lnls-dig/rffe-hw/circuit_board/controller/manufacturing/RFFE_Controller_PCB_specs.docx

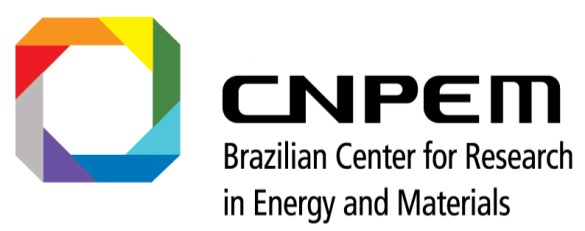
[picture p1: figure]
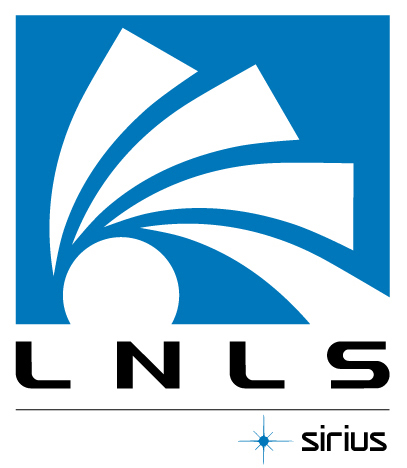
[picture p2: figure]

RFFE_Controller_v7

Manufacturing specifications

November 2015

Beam Diagnostics Group (DIG)

BLANK PAGE

# PCB Fabrication Specification

Design references
Name | RFFE_Controller_v6 | | Date: 25/11/2014
File name
Designer | Rafael Antonio Baron | Fernando Sant’anna
E-mail | | fernando.santanna@lnls.br
Fone | | +55 19 3512-5071
Cel | | +55 19 99206-8595

Mechanical characteristics
External size (mm) | 87 mm x 105 mm
Thickness (mm) | 1.6 mm
Multilayers | 4 layers
Min track width (mm/mils) | 0.1mm
Min Hole size (mm/mils) | 0.254mm
Laminate | FR-4 – TG150
Pre-preg | FR-4 – TG150

Finish Copper
External layers (µm) | 35 µm
Holes walls (µm) | 25 µm
Internal Layers-Planes (µm) | 35 µm
Internal Layers-Signals (µm) | 35 µm

Board finishing requirements
Mask Solder color | Red for prototype and Blue for production
Silkscreen on top layer (color) | White
Silkscreen on bottom layer (color) | White
Surface Finishing | ENIG – Electroless Nickel / Immersion Gold according to IPC-4552
Thickness | Ni: 3 µm min, 6 µm máx. Au: 0.05 µm min, 0.125 µm máx

Additional Information
Impedance test | No
Packaging requirements | No
Documentation to be delivered | No
Additional control quality requirements | No

Board Stackup Information
Layer 1 | RF signals | Laminate/pre-preg | Thickness (mm/mils)
Layer 2 | RF Ground Plane | FR4 | 20 mils
Layer 3 | Digital signaling | FR4 | 20 mils
Layer 4 | Digital Ground plane | FR4 | 20 mils

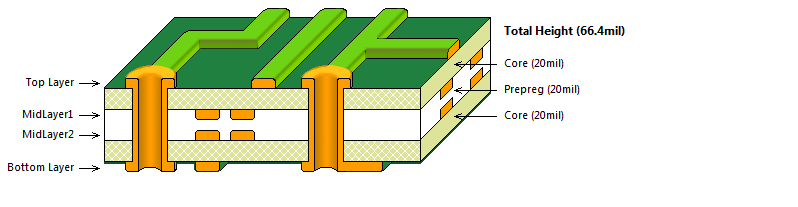
[picture p3: figure]

60 mils (1.6 mm)

Centro Nacional de Pesquisa em Energia e Materiais (CNPEM) Laboratório Nacional de Luz Síncrotron (LNLS) Rua Giuseppe Maximo Scolfaro, 10000, Polo II de Alta Tecnologia Campinas, São Paulo, Brazil CEP 13083-970 – Caixa Postal 6192

Last update: 23 May 2016 - 15:59 4
