lnls-dig/rffe-hw/circuit_board/rf_channels/manufacturing/RFFE_PCB_specs.docx

RFFE_v2_AC

RFFE_v2_BD

Manufacturing specifications

November 2015

Beam Diagnostics Group (DIG)

BLANK PAGE

# PCB Fabrication Specification

Design references
Name | RFFE_V2_AC and RFFE_V2_BD | | Date: 25/11/2014
File name
Designer | Rafael Antonio Baron | Fernando Sant’anna
E-mail | | fernando.santanna@lnls.br
Fone | | +55 19 3512-5071
Cel | | +55 16 99206-8595

Mechanical characteristics
External size (mm) | 50 mm x 105 mm
Thickness (mm) | 1.6 mm
Number of layers | 4 layers
Min track width (mm/mils) | 0.203mm / 8 mils
Min Hole size (mm/mils) | 0.200mmm / 7.8 mils
Laminate | RO4350 on top layer
Pre-preg | FR-4

Finish Copper Thickness
External layers (µm) | 35 µm
Via plating (µm) | 25 µm
Internal Layers-Planes (µm) | 35 µm
Internal Layers-Signals (µm) | 35 µm

Board finishing requirements
Silkscreen on top layer (color) | White
Silkscreen on bottom layer (color) | White
Board color | Red
Surface Finishing | ENIG – Electroless Nickel / Immersion Gold according to IPC-4552
Thickness | Ni: 3 µm min, 6 µm máx. Au: 0.05 µm min, 0.125 µm máx

Additional Information
Impedance test | No
Packaging requirements | No
Documentation to be delivered | No
Additional control quality requirements | No

Board Stackup Information
Layer 1 | RF signals | Laminate/pre-preg | Thickness (mm/mils)
Layer 2 | RF Ground Plane | RO4350 | 20 mils
Layer 3 | Digital signaling | FR4 | 20 mils
Layer 4 | Digital Ground plane | FR4 | 20 mils

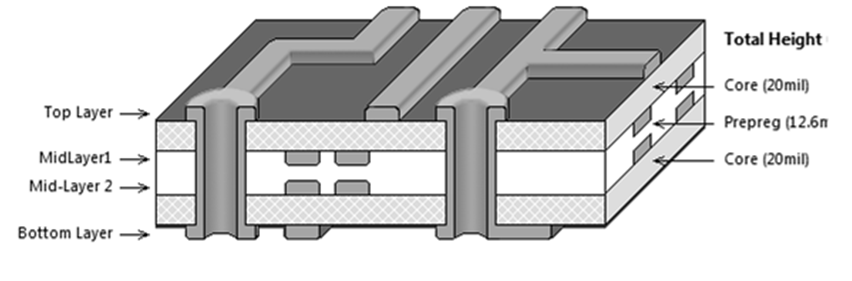
[picture p4: figure]

(20 mil) Rogers RO4350

(20 mil) FR-4

(20 mil) FR-4

60 mils (1.6 mm)

Centro Nacional de Pesquisa em Energia e Materiais (CNPEM) Laboratório Nacional de Luz Síncrotron (LNLS) Rua Giuseppe Maximo Scolfaro, 10000, Polo II de Alta Tecnologia Campinas, São Paulo, Brazil CEP 13083-970 – Caixa Postal 6192

Last update: 5 January 2016 - 11:08 4
