lnls-dig/rffe-hw/mechanical/RFFE_SET_BOM/BOM for 1U 19Pol two box RFFE.xlsx

BILL OF MATERIALS
Project: | 1U - 19" Two box RFFE | REV.: 1 | Data: | 29/10/2015
Quantity | Description | Manufacturer PN | Manufacturer | Link
2 | Light pipe for front panel | 51513010125F | Dialight | http://www.digikey.com/product-detail/en/51513010125F/350-3721-ND/4965176 | 0.86 | 3.44
1 | Panel 1U 19" for two RFFE units and Screws | PAINEL_RFFEv1BI | HDL USINAGEM | send to: fernando.santanna@lnls.br to take a mechanical drawings
2 | Cable Flex RED - 24AWG - 10cm | AP107177 | Mult Cabo | send to: fernando.santanna@lnls.br to take a mechanical drawings | 1 | 4
2 | Cable Flex Black - 24AWG - 10cm | AP107176 | Mult Cabo | send to: fernando.santanna@lnls.br to take a mechanical drawings | 1 | 4
2 | Rocker switch | RB141C1000-114 | E-Switch | http://www.digikey.com/product-detail/en/RB141C1000-114/RB141C1000-114-ND/3778078 | 1.09 | 4.36
2 | Mechanical enclosure RFFE box + 2x shield 2mm | BOX_RFFEv5BI | HDL USINAGEM | send to: fernando.santanna@lnls.br to take a mechanical drawings
2 | Fuse holder(slot) | BK/HTB-52M-R | Eaton Bussmann | http://www.digikey.com/product-detail/en/BK%2FHTB-52M-R/283-3839-ND/1024133 | 7 | 28
2 | Fuse 2A 5x20 | 0217002.HXP | Littelfuse Inc. | http://www.digikey.com/product-detail/en/0217002.HXP/F2393-ND/777109 | 1 | 4
2 | CONN DUST COVER - MINI USB BLACK | MUSB2E151015BP | Amphenol | https://www.amphenolcanada.com/ProductSearch/drawings/AC/MUSB2E1510X5BP.pdf | 1.5 | 6
2 | Terminal block with EMI filter | 7602-602NLF | Tusonix CTS Electronic | http://www.digikey.com/product-search/en?vendor=0&keywords=7602-602NLF | 23.04 | 92.16
2 | LASER printer Label ID whith QRCode 12x26mm | A5Q-1226 A5 | Etiqueta Pimaco | http://www.pimaco.com.br/produto/186/a5q-1226-etiquetas-a5-12-folhas | 0.01 | 0.04
 |  |  |  |  |  | 146
