lnls-dig/rffe-hw/(list of files, cad)

Other CAD files:
mechanical/RFFE_panel_1U_19_Pol/assembly_box_and_panel_1U.dwg
mechanical/RFFE_box/RFFE_box.dwg
mechanical/RFFE_panel_1U_19_Pol/RFFE_panel_1U_19pol.dwg
mechanical/RFFE_sink_2mm/heat_sink.dwg
mechanical/RFFE_box/RFFE_box.ipt
mechanical/RFFE_panel_1U_19_Pol/RFFE_panel_1U_19pol.ipt
mechanical/RFFE_panel_1U_19_Pol/assembly_box_and_panel_1U.iam
mechanical/RFFE_sink_2mm/heat_sink.ipt
