lnls-dig/rffe-hw/(list of files, drawings)

Other design files:
circuit_board/controller/RFFE_Controller.PrjPcb
circuit_board/controller/RFFE_Controller.SchDoc
circuit_board/rf_channels/RFFE.PrjPCB
circuit_board/rf_channels/RFFE.SchDoc
circuit_board/rf_channels/RFFE_AC.PcbDoc
circuit_board/rf_channels/RFFE_BD.PcbDoc
