lnls-dig/rffe-hw/(threads)

Thread 1 (2016-05-17):

Change footprints to avoid paste over via

aylons, 2016-05-17:
Paste over via may lead to improper connection and should be avoided. The footprints of TA1114A and TAMP72 have obvious instances of this problems, but a quick inspection has shown it happens several times.

Footprints and vias in all componentes should be revised to avoid this design.

Closed 2016-07-19.

Thread 2 (2016-05-18):

Via under switch pad is smaller than others

aylons, 2016-05-18:
The via under the RF switch is the only hole with 0.200 mm, requiring change of tooling for building a single hole. All others are 0.203 (8mil), which is perfectly adequate for this component footprint.

Closed 2016-07-19.

Thread 3 (2016-07-06):

Replace MBED with LPC176x controller

henrique-silva, 2016-07-06:
Using a MBED board here is a real overkill, since we only use some basic functions provided by it.
We could replace the MBED with a single LPC176x (1768 is the more suitable probably, 1769 for clocks up to 120MHz) and, with just some resistors added, we would have the same functionality.
This change would untie us from a specific product such as MBED and significantly reduce production costs.

The firmware would not need any changes if the pinout is the same as MBED, but we would lose the ability to flash the firmware via USB (drag'n'drop).
We could also use here [openMMC](https://github.com/lnls-dig/openMMC) and reimplement the current logic in separated modules, but this firmware doesn't have a fully tested Ethernet interface yet.

aylons, 2018-04-25:
This is being addresd by https://github.com/lnls-dig/rffe-uc-hw/

Closed 2018-04-25.

Thread 4 (2016-07-19):

Change heating resistors to SMD type

aylons, 2016-07-19:
The heating resistors are the last non-SMD devices in the RFFE board. Changing them to a SMD part would minimize the chance of production error by avoiding unnecessary soldering iron process.

Closed 2018-01-24.

Thread 5 (2018-04-25):

Correct pull-up/down variant for clock input

aylons, 2018-04-25:
The clock input should not have both up and down pulls, it should be chosen between two variants. The resistor value should also be changed to something closer to 50 ohms, as this is the connector impedance.

Thread 8 (2018-08-14):

Change EOL'ed parts in the schematic

aylons, 2018-08-14:
Two parts were EOL'ed and need to be replaced in the schematic:

MACOM MASWSS0184 (https://www.macom.com/products/product-detail/MASWSS0184 to replace the RFSW switch.
IDT F1953 https://www.idt.com/products/rf-products/rf-attenuators/f1953-6-bit-050db-glitch-free-digital-step-attenuator-internal-dc-blocks) to replace Mini-circuits DAT-31R5 attenuator.

Thread 9 (2022-11-10):

Change RF frequency

mo2020, 2022-11-10:
We are going to use RFFE in our machine with RF frequency of 100MHz, We are wondering if anyone highlight any changes are required in RFFE.

danielot, 2022-11-10:
Hello @mo2020. The bandpass filters (TA1113A) would definitely have to be replaced if you want to operate on the first beam harmonics, but you may want to evaluate whether 100 MHz is the best harmonics to work with. If you can get more signal from your pick ups (after cables) at higher harmonics (e.g. 300 MHz, 500 MHz) these other frequencies could be better options.

Some thoughts about switching to a different center frequency:
- Optimize the bandpass filter response by replacing TA1113A
- It may be hard to find a footprint-compatible BPF replacement - check here https://www.taisaw.com/en/product.php?pc=1&p=1. A slight redesign of the PCB layout may be required. No problem with that.
- If you end up working with very low frequency (e.g. 100 MHz) and your digitizer has enough sampling rate (e.g. >= 250 MHz) you could consider using a low pass as replacement for the bandpass. Unalisaed noise can be easily filtered digitally.
- Replace all FCN-530+ low pass filters to match the proper cutoff (center frequency + bandwidth of interest + some slack for filter rolloff)

aylons, 2022-11-10:
If you have the chance, considering switching the microcontroller to something easily available. Also, pay attention to all clocks and harmonics on it - we had problems with the 4th harmonic of the ethernet clock (125MHz - 500MHz). This is a very low-demand circuit and it will usually be better to choose based on availability and compatibility.

aylons, 2022-11-10:
On the analog side of things: the switch was discontinued after Qorvo acquired the old manufacturer. Luckily the [recommended alternative](https://www.qorvo.com/products/p/RFSW6222) seems to fit the application, but I recommended very careful vetting and maybe considering other part numbers. Qorvo bought a lot of companies the market in this field, so there may not be many options outside of them.

The attenuator DAT-31R5-SP+ was discontinued, and the recommendation DAT-31R5A-SP+ has a noticeable spurious (actually more like quivck variations on S21) if not supplied with a negative voltage, which the current design does not have.

This issue #8 has options for both changes, but take note that this hasn't been looked for a couple years AFAIK.

rabaron, 2022-11-11:
Hello @mo2020 !

-	Additionally to what was commented above, the RF amplifier has a lower cutoff frequency of around 400 MHz. You would need to consider other options. I would recommend taking a look at other options.
-	Check the AC coupling capacitors since the 100 pF ones may add some insertion loss at 100 MHz and impedance mismatch to the RF chain. They will also depend on the RF switch and amplifier you chose.
-	There is a new type of RF switch that is called "low gate lag" that may improve the performance of the switch we have used on this project. We observed a slow 100% stabilization time for ordinary RF switches (from 99% to 100% stabilization) and the low gate lag models reach the 100% stabilization time much faster. For example, the MASW-007587.
-	I would also add an extra input matching network based on Pi architecture so that you are able to fine tune the impedance of the RF chain for your application before you send all the units for final production.
