lnls-dig/rffe-hw/(commit log)

2016-01-05 First revision
    Commited well after development. This is the single-board RFFE,
    developed in 2013.
    [EBPM-RFFE-Ver1.PrjPCB, RFFE-Pilot-Ver1.SchDoc, RFFE-Supply-Ver1.SchDoc, RFFE-Supply-v2.SchDoc, RFFE-Ver1.PcbDoc, RFFE-Ver1.SchDoc]
2016-01-05 Second RFFE version, based on old project
    This version was developped on 2013 and commited later to follow the
    history. This is still the 'big-board' version for evaluation.
    [EBPM-RFFE-BOM.xlsx, EBPM-RFFE-Ver1.PrjPCB, EBPM-RFFE.PrjPCB, RFFE-Pilot-Ver1.SchDoc, RFFE-Pilot.SchDoc, RFFE-Supply-Ver1.SchDoc, RFFE-Supply-v2.SchDoc, RFFE-Ver1.PcbDoc]
2016-01-05 First small-board version
    This is the first version with the small board, with 2x2 switching and
    without the pilot tone. This also includes the first RFFE controller,
    which was marked as v6 in the original files. This commit was made well
    after development, which ended in 2014.
    [BOM_RFFE.xls, EBPM-RFFE-BOM.xlsx, EBPM-RFFE.PrjPCB, RFFE-Pilot.SchDoc, RFFE.PrjPCB, RFFE.SchDoc, RFFE_AC.PcbDoc, RFFE_BD.PcbDoc]
2016-01-05 First manufacturing test
    Manufactured in 2014, first tested on complete rack. Several bug fixes,
    added new amplifier.
    [BOM_RFFE AC_BD.xlsx, BOM_RFFE.xls, BOM_RFFE_Controller.xlsx, RFFE.PrjPCB, RFFE.SchDoc, RFFE_AC.PcbDoc, RFFE_BD.PcbDoc, RFFE_Controller.PrjPcb]
2016-01-05 Added first version of mechanical drawings for case and rack mount.
    Created new folder with drawings for manufacturing mechanical case and
    labeling. ipt (source files) and dwg (building drawings) are added to
    version control
    [BOM for 1U 19Pol two box RFFE.xlsx, RFFE_box.dwg, RFFE_box.ipt, RFFE_panel_1U_19pol.dwg, RFFE_panel_1U_19pol.ipt, assembly_box_and_panel_1U.dwg, assembly_box_and_panel_1U.iam, heat_sink.dwg]
2016-01-08 organize path for files in prjPCB
    [RFFE_Controller.PrjPcb]
2016-01-08 organized paths files in prjPCB
    [RFFE.PrjPCB, RFFE_BD.PcbDoc]
2016-01-27 Changed bandpass filter for Sirius frequency
    The old filter, TA1113A, was more adequate for UVX frequency. Now uses
    TA1114A, more apt for Sirius RF frequency.
    [RFFE.SchDoc]
2016-01-27 Added variant for UVX
    The variant for UVX uses a different bandpass filter, TA1113A, instead
    of Sirius' TA1114A.
    [RFFE.PrjPCB]
2016-02-05 reorganization of folders structure
    keep consistency wiht other Open Hardware projects
    remove duplicated files
    [BOM for 1U 19Pol two box RFFE.xlsx, BOM_RFFE_AC_BD.xlsx, BOM_RFFE_Controller.xlsx, RFFE.PrjPCB, RFFE_AC.PcbDoc, RFFE_AC.SchDoc, RFFE_BD.PcbDoc, RFFE_BD.SchDoc]
2016-02-05 reorganize project files
    use only one PCB per project
    [RFFE.PrjPCB, RFFE.SchDoc, RFFE_AC.PcbDoc, RFFE_AC.PrjPCB, RFFE_AC.SchDoc, RFFE_BD.PcbDoc, RFFE_BD.PrjPCB, RFFE_BD.SchDoc]
2016-02-05 add open hardware license notice on schematics
    [RFFE.SchDoc, RFFE_Controller.SchDoc]
2016-04-27 Changed IC16 value and variant for UVX
    [RFFE.SchDoc, RFFE_AC.PrjPCB, RFFE_BD.PrjPCB]
2016-05-17 Added data to RF PCB manufacturing
    Added copper finish data and minimum sizes to help fabrication.
2016-05-23 BOM PN IC6 change
    change PN: DAC7553IDGS to DAC7554IDGS on IC6
    [BOM_RFFE_Controller.xlsx]
2016-06-29 change library components
    [RFFE_Controller.PrjPcb, RFFE_Controller.SchDoc]
2016-06-29 alternative for IC1 ICS8304AMLFT to ICS651MLF
    [RFFE_Controller.SchDoc]
2016-06-30 more components of new library
    [RFFE_Controller.SchDoc]
2016-07-04 update SCH and PCB library components
    [RFFE_Controller.SchDoc]
2016-07-04 change all components to TOP Layer
    [RFFE_Controller.PrjPcb]
2016-07-06 initial change library refeence RFFE AC and BD
    [BOM_RFFE_AC_BD.xlsx, RFFE.PrjPCB, RFFE.SchDoc, RFFE_AC.PcbDoc, RFFE_AC.PrjPCB, RFFE_BD.PcbDoc, RFFE_BD.PrjPCB]
2016-07-06 new changes
    [RFFE.PrjPCB, RFFE.SchDoc, RFFE_AC.PcbDoc, RFFE_BD.PcbDoc]
2016-07-11 Changed switch control fanout IC for better availability
    [RFFE_Controller.SchDoc]
2016-07-12 change position track 5v on Bottom Solder shield
    [RFFE.SchDoc]
2016-07-12 change Controller PCB - IC1 to CDCLVC1103PW
    [RFFE.SchDoc, RFFE_Controller.SchDoc]
2016-07-12 add footprint mark MINI-CIRCUITS_FV1206 indicate RF in pin 1
2016-07-13 removed pullups from ic2 temp sensor
    CT and INT are open drain outputs and may be safely grounded
    [RFFE.SchDoc]
2016-07-14 approach temperature sensor IC switch
    [RFFE.SchDoc]
2016-07-14 change names x PCB layouts AC <> BD
    [RFFE.PrjPCB]
2016-07-18 change TOP PASTE and TOP SOLDER for ICs
    [RFFE.PrjPCB]
2016-08-01 change coluns on BOM generator
    [RFFE.PrjPCB, RFFE.SchDoc, RFFE_Controller.PrjPcb]
2016-08-05 change R10 and R11 to SMD
    [RFFE.PrjPCB, RFFE.SchDoc]
2016-08-23 Removed layers not used
    [RFFE_Controller.PrjPcb]
2016-08-25 organized Layers names
    [RFFE.PrjPCB, RFFE_Controller.PrjPcb]
2016-09-14 Added fiducial in three models
    [RFFE.SchDoc, RFFE_Controller.PrjPcb, RFFE_Controller.SchDoc]
2017-02-17 Corrected LT1764 regulator part number
    [RFFE_Controller.PrjPcb, RFFE_Controller.SchDoc]
2017-04-04 Removed BOM file from controller
    [BOM_RFFE_Controller.xlsx]
2017-04-20 Changed PAD on SMA central pin to same width in the track
    Changed PAD on SMA central pin to same width in the track and revised to
    v4.
    [RFFE.PrjPCB, RFFE.SchDoc]
2017-04-24 Add pull up and down input Switching logic
    change fixed pads to 5mm and revision to v9
    [RFFE.PrjPCB, RFFE_Controller.PrjPcb, RFFE_Controller.SchDoc]
2017-07-11 Changed temperature sensor in the schematics
    [RFFE.SchDoc]
2017-07-12 Updated temperature sensor in PCB layout
    [RFFE.SchDoc]
2017-07-18 Updated version number in boards
    [RFFE.SchDoc]
2017-07-18 Some output generation documentation added
    [RFFE.PrjPCB, RFFE_Controller.PrjPcb]
2017-08-07 Changed footprint for SMA connectors.
    [RFFE.PrjPCB, RFFE.SchDoc]
2017-08-15 Added filters to avoid noise from mbed to reach the RF signals
    [RFFE.PrjPCB, RFFE.SchDoc, RFFE_Controller.PrjPcb, RFFE_Controller.SchDoc]
2017-08-15 Changed filter for switch input
    [RFFE.SchDoc]
2017-08-15 Updated version numbers in schematics and layout
    [RFFE.SchDoc, RFFE_Controller.SchDoc]
2017-08-17 Added OutJob files
    [RFFE.PrjPCB, RFFE.SchDoc, RFFE_Controller.PrjPcb]
2017-08-24 Changed SMA footprint for better soldering
2017-08-24 Added outputjob file for RFFE
    [RFFE.PrjPCB]
2017-09-06 Corrected IC16 in controller, which had a faulty library data
    [RFFE_Controller.SchDoc]
2017-09-18 Minor overlay adjustments
    [RFFE_Controller.PrjPcb]
2017-09-18 update parameters for R31
    [RFFE_Controller.SchDoc]
2017-09-18 add P&P in outjobs
    [RFFE.PrjPCB]
